troberson/artemis-project/CWC_Report/titlepage/titlepage.tex

\documentclass[../ewet_cwc_report.tex]{subfiles}

\NewDocumentCommand{\name}{m}{\underline{\textbf{#1}}}

\begin{document}

\makeatletter
\begin{titlepage}
  \begin{minipage}[T]{0.45\textwidth}
    \begin{flushleft}
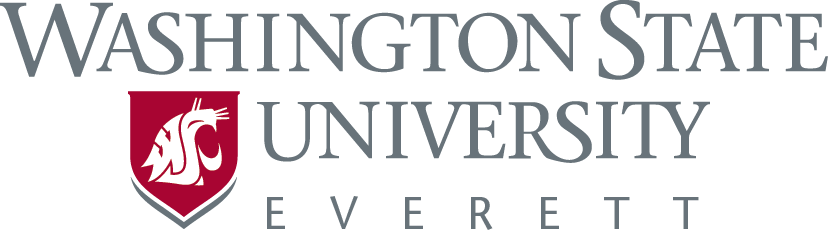
[picture p39: CWC_Report/_images/wsu.png]
      
    \end{flushleft}
  \end{minipage}
  \begin{minipage}[T]{0.45\textwidth}
    \begin{flushright}
      
    \end{flushright}
  \end{minipage}

  \centering
  \vspace*{5cm}

  {\large
    Washington State University-Everett and\\
    Everett Community College \\
    Collegiate Wind Competition \\
    Final Report\\
    April 24, 2022
  }

  \vspace*{20ex}

  \textbf{Team Members}
  \vspace*{1ex}

  \begin{tabular}{cccc}
    \name{Steven Fordham} &
    \name{James Garfield} &
    \name{Boris Gindlin}    \\
    WSU                   &
    EvCC                  &
    WSU                     \\
    Electrical Team Lead  &
    MakerPlot Research    &
    Electrical Design       \\
    Turbine Controls      &
                          &
    Generator Design        \\
    Electrical Design     &
                          &
    Load Design
  \end{tabular}

  \vspace*{2ex}

  \begin{tabular}{cc}
    \name{Dan}           &
    \name{Tamara Roberson} \\
    WSU                  &
    WSU                    \\
    Mechanical Team Lead &
    Load Controls          \\
    Aerodynamics           \\
    Foundation Design      \\
    Rotor and Pitch Control Design
  \end{tabular}

  \vspace*{4ex}

  \textbf{Faculty Advisors}
  \vspace*{1ex}

  \begin{tabular}{ccc}
    \name{Gordon Taub}     &
    \name{Joe Graber}      &
    \name{Xie Shuzheng}      \\
    WSU                    &
    EvCC                   &
    WSU                      \\
    Principle Investigator &
    Co-PI                  &
    Co-PI
  \end{tabular}

\end{titlepage}
\makeatother

\end{document}
