troberson/artemis-project/Presentation/Offshore Wind Turbine Prototype.pptx

## Offshore Wind Turbine Prototype

Tamara Roberson
Candidate for Associate Software Engineer

## Who Am I?

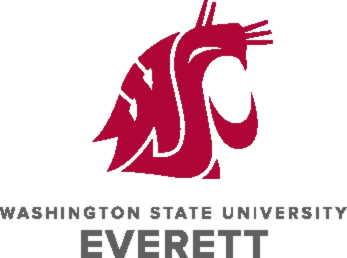
[picture p40: figure]

- Tamara Roberson
- Graduating from WSU Everett with a BSEE this week
- Starting a career in embedded software
- Hobby: Board Games

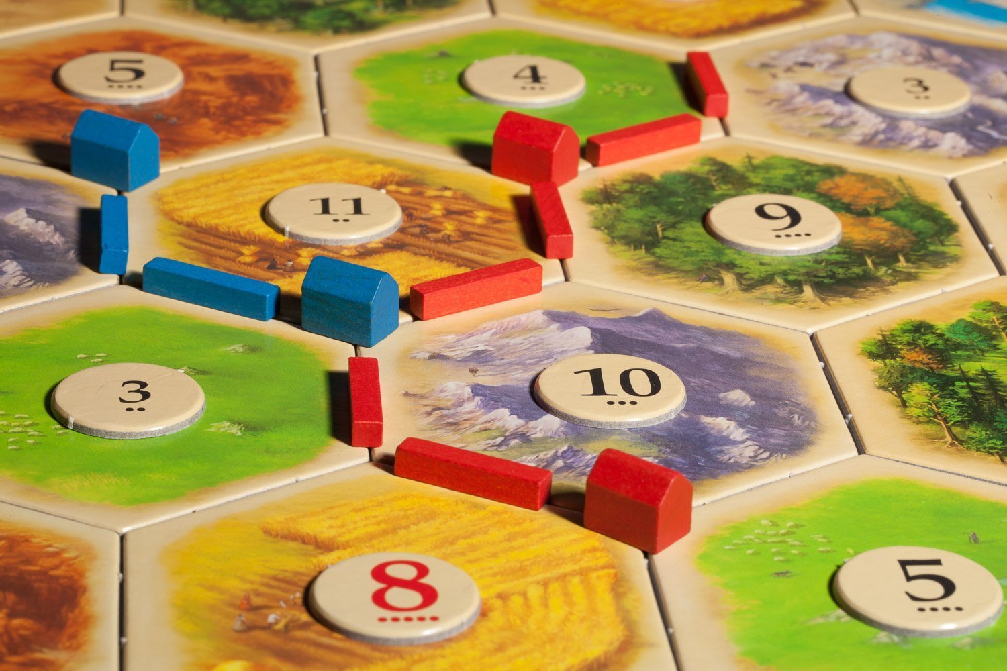
[picture p41: figure]

## Who Are You?

- Name
- Specialization
  - Not your job title
  - What are you the “go to” person for?
  - React? Analog ICs? LaTeX?
- Hobby
  - Open-Source Software? Video Games? Hiking? Museums?

## The Team

- Senior Design Project and Engineering Club Team
- US Department of Energy Collegiate Wind Competition
- Team of 3 EEs, 1 ME
  - Club also includes several Business and Communications students for outreach and wind farm business analysis

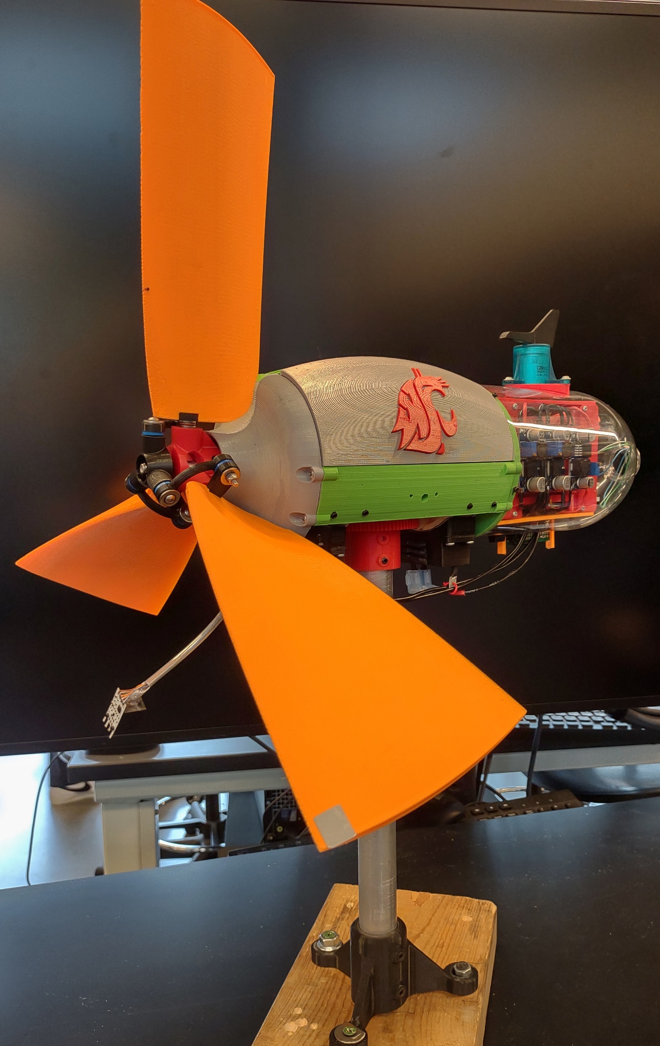
[picture p42: figure]

## Design Considerations

- Collegiate Wind Competition rules
- Offshore wind turbine designed to be installed in the Gulf of Mexico
