troberson/artemis-project/Midterm_Report/ext/tasks.pdf

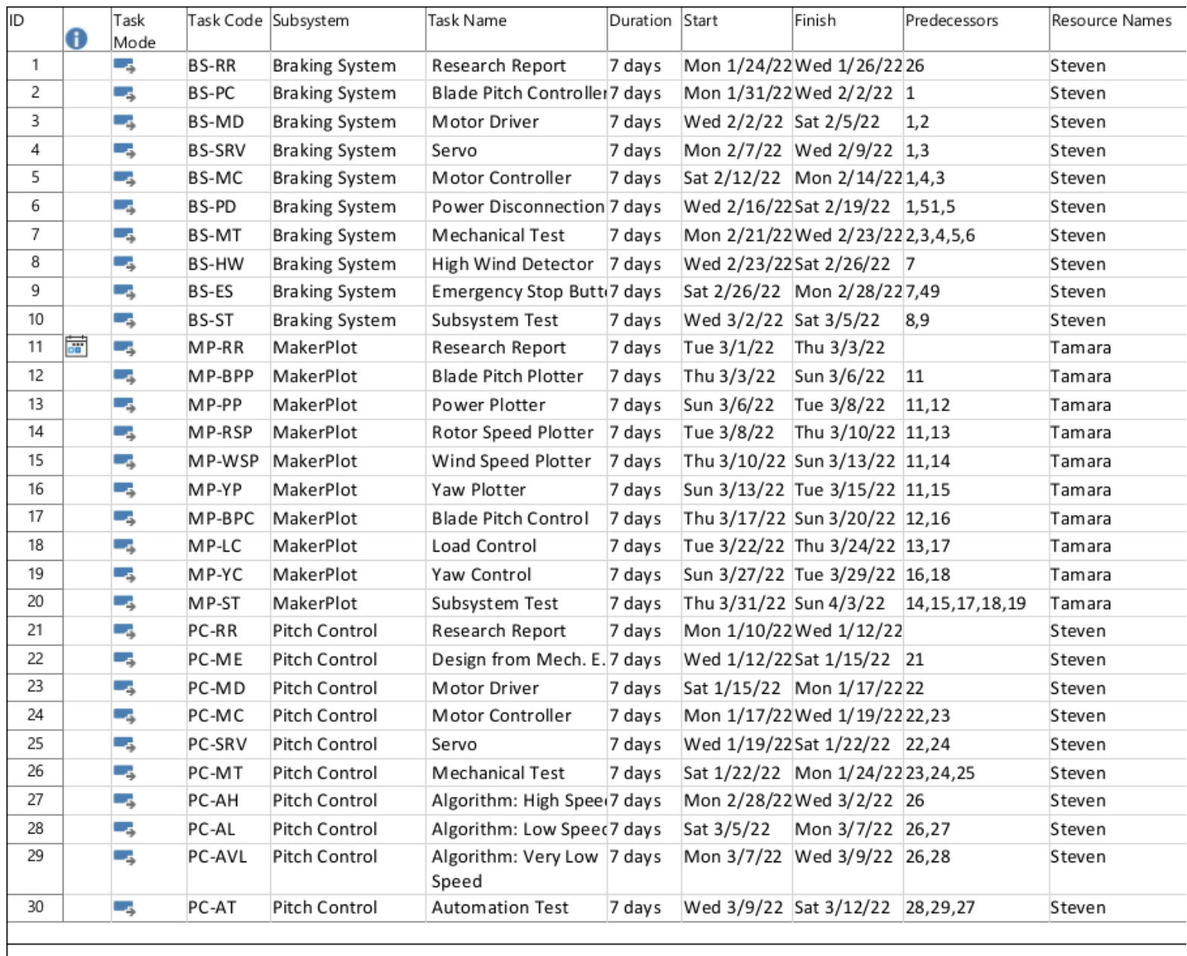
[picture p43: page 1]
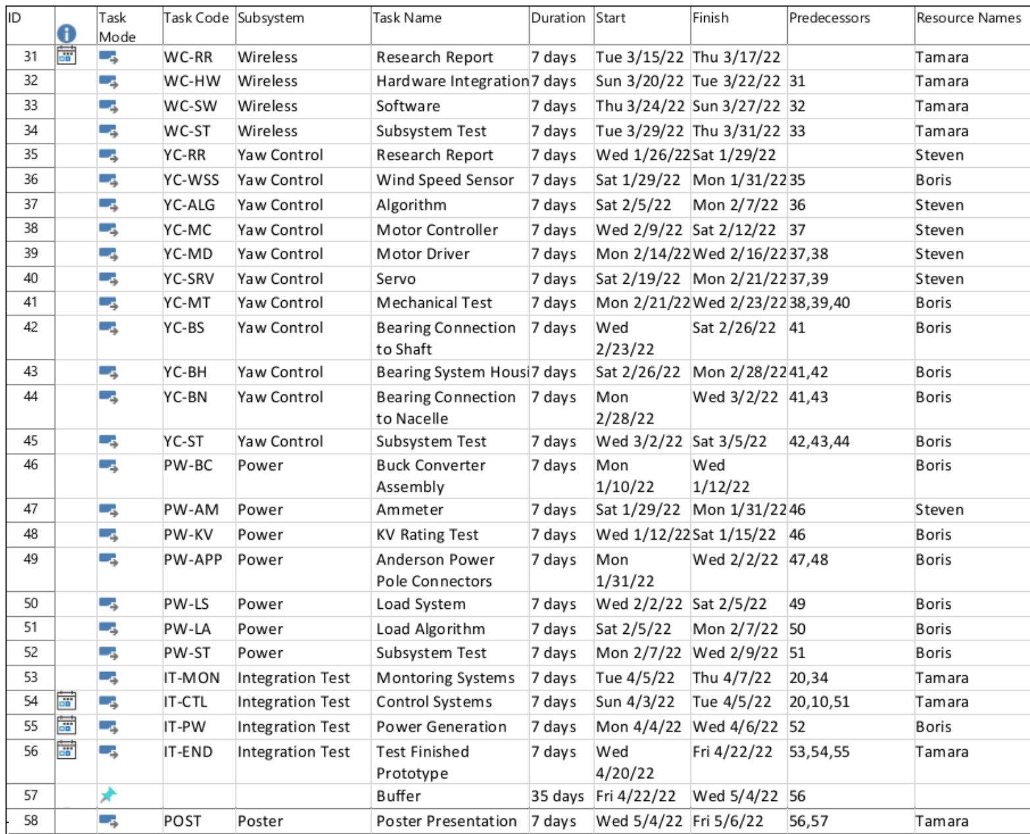
[picture p44: page 2]
