troberson/artemis-project/Midterm_Report/images/load_control.png

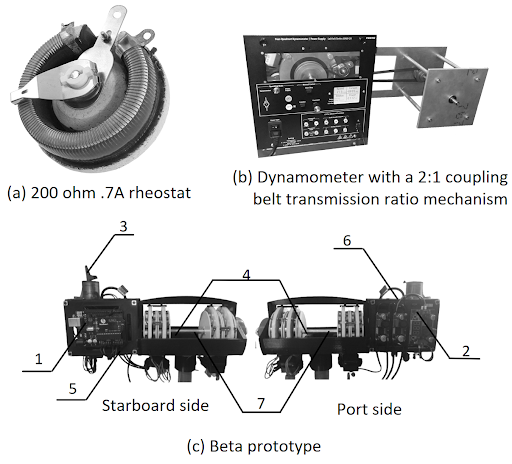
Midterm_Report/images/load_control.png
