troberson/artemis-project/Presentation/afpmg2.png

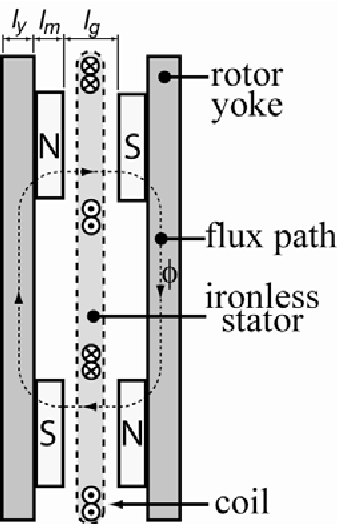
Presentation/afpmg2.png
