troberson/artemis-project/Presentation/afpmg.png

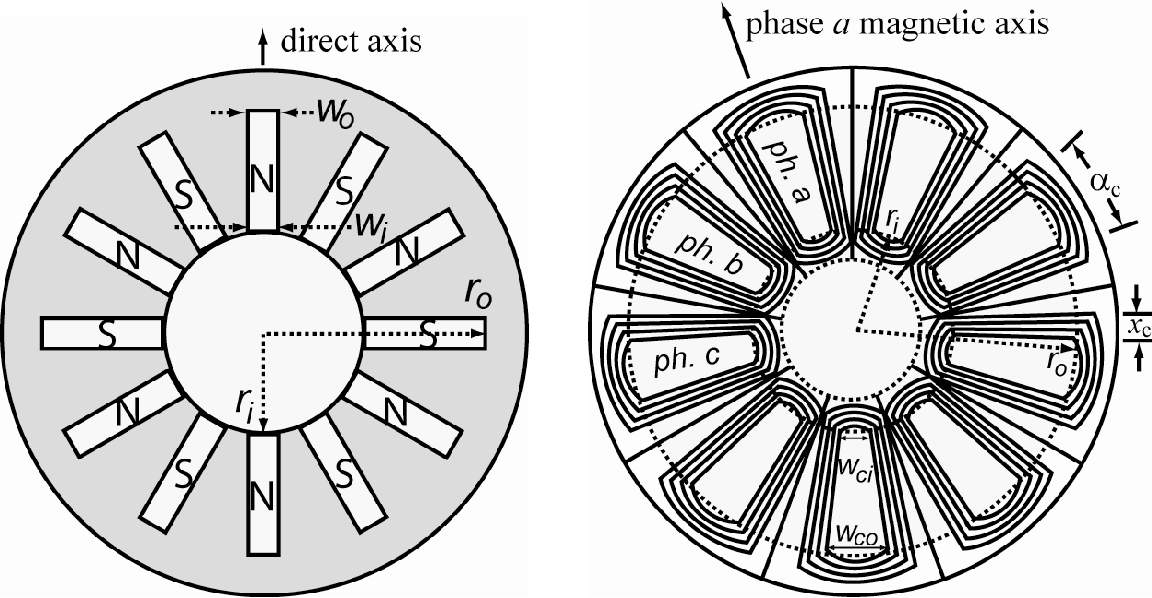
Presentation/afpmg.png
