troberson/artemis-project/Presentation/arduino_load.jpg

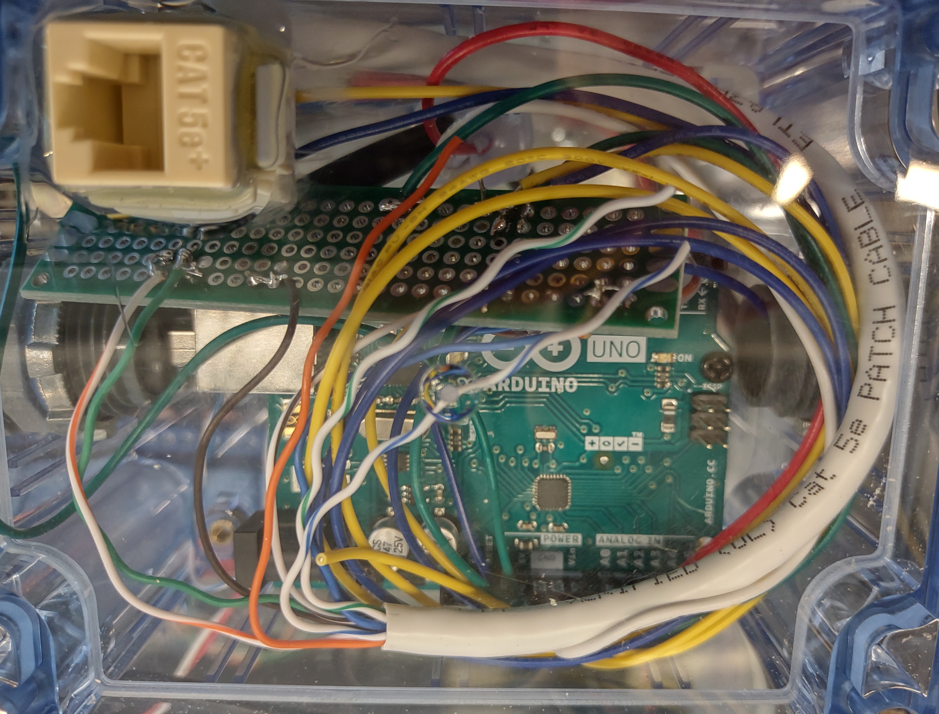
Presentation/arduino_load.jpg
