troberson/artemis-project/Presentation/arduino_turbine.jpg

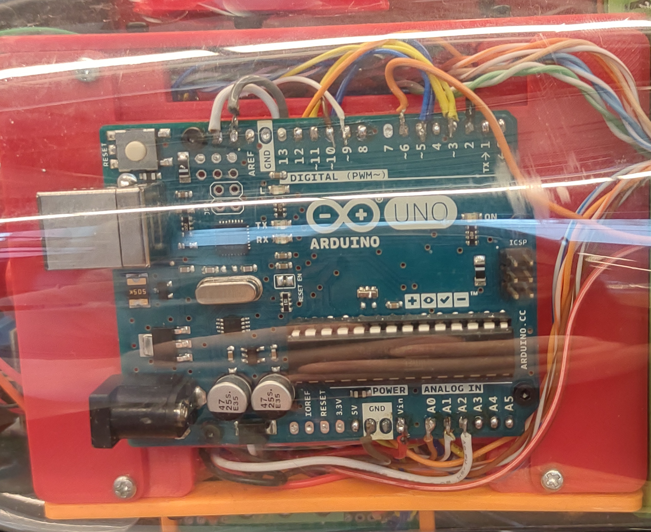
Presentation/arduino_turbine.jpg
