troberson/artemis-project/Presentation/buck.jpg

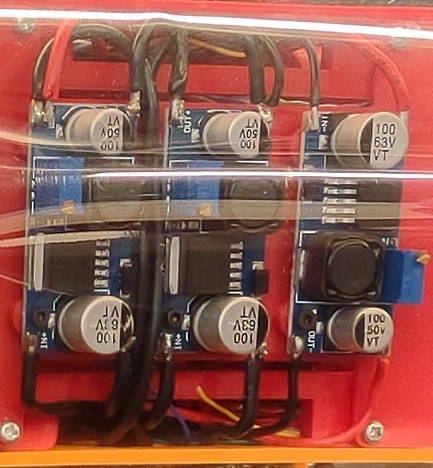
Presentation/buck.jpg
