troberson/artemis-project/Presentation/cwc.png

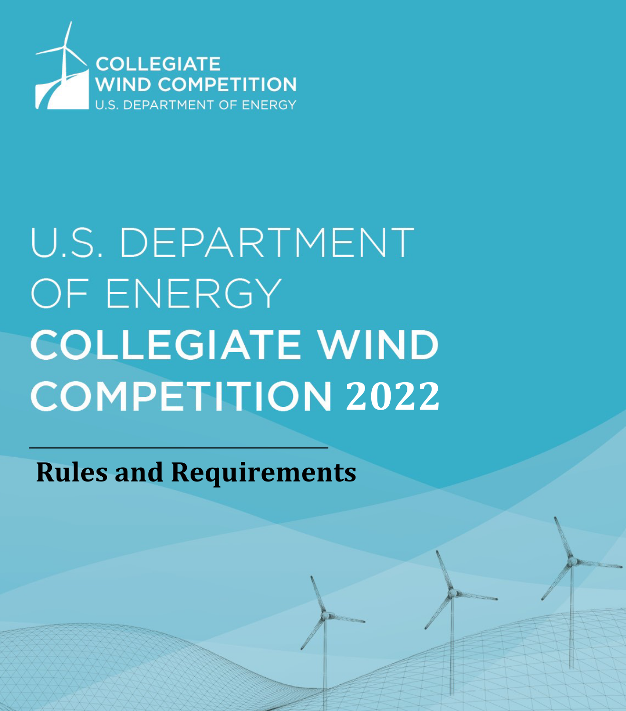
Presentation/cwc.png
