troberson/artemis-project/Presentation/generators.jpg

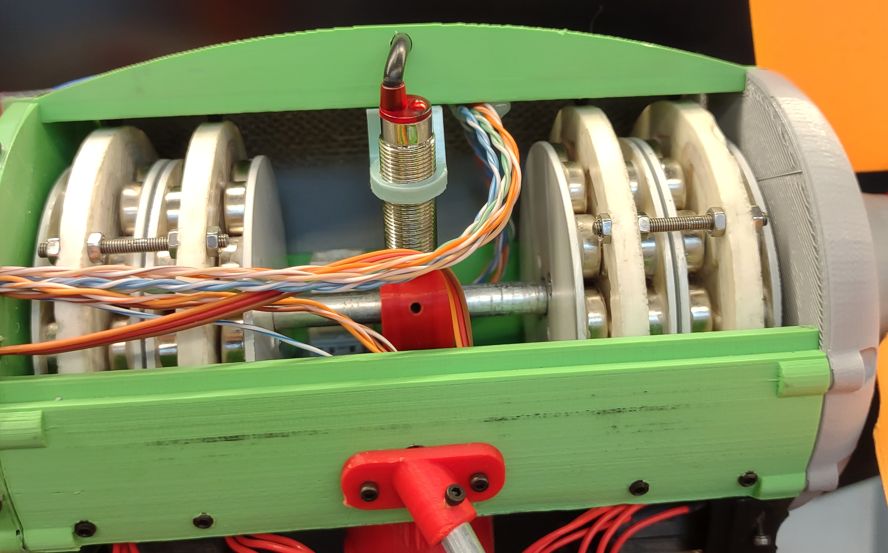
Presentation/generators.jpg
