troberson/artemis-project/Presentation/group.jpg

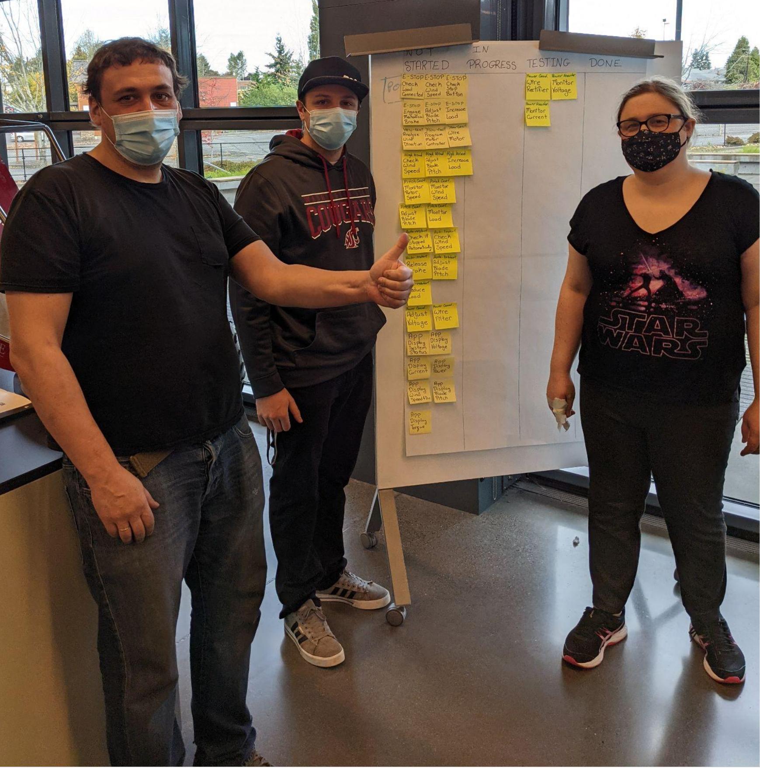
Presentation/group.jpg
