troberson/artemis-project/Presentation/load_box.jpg

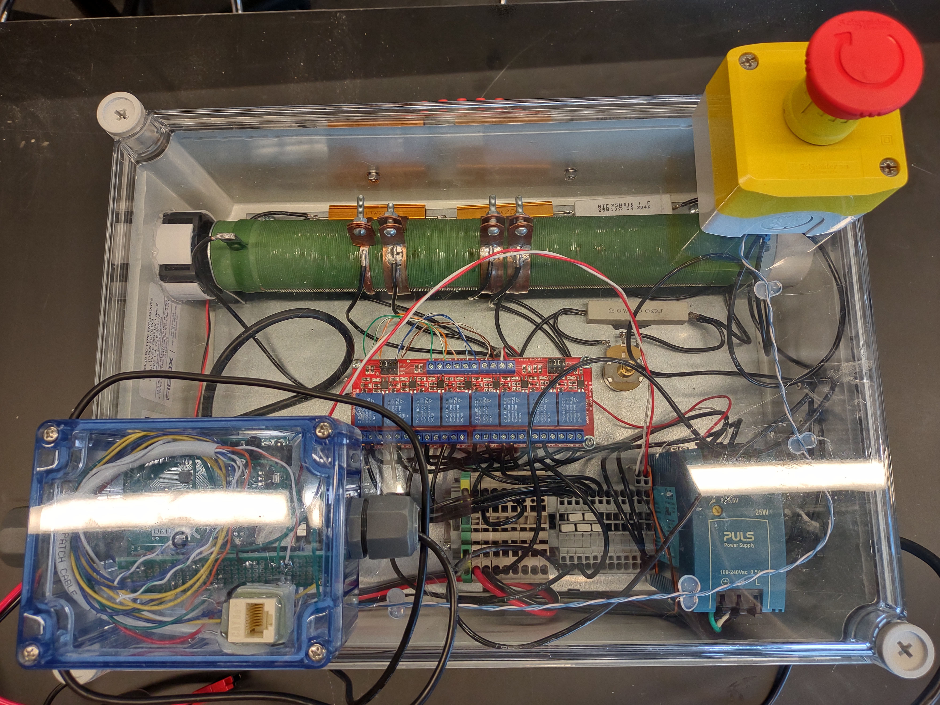
Presentation/load_box.jpg
