troberson/artemis-project/Presentation/pitch_control.png

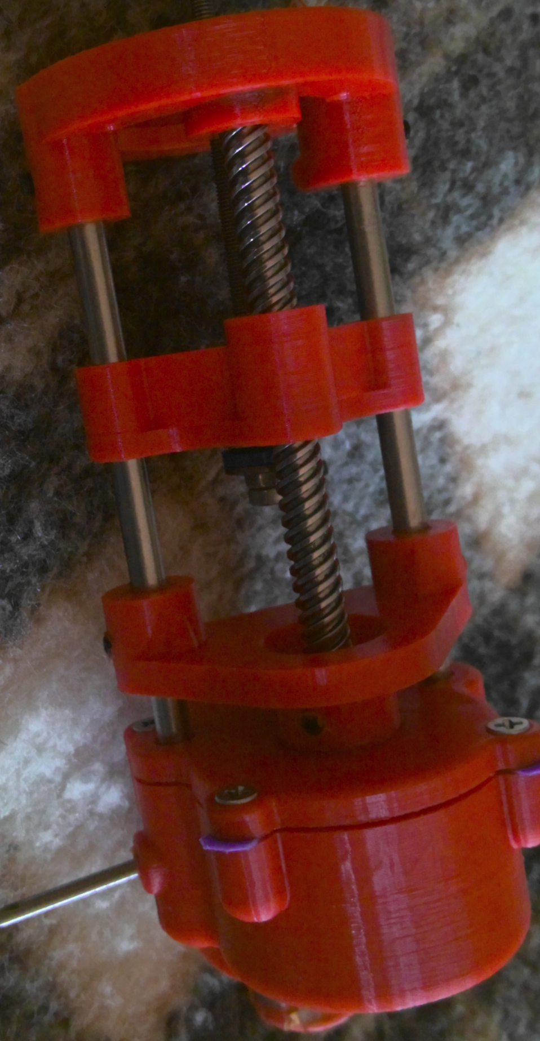
Presentation/pitch_control.png
