troberson/artemis-project/Presentation/precedence_closeup.png

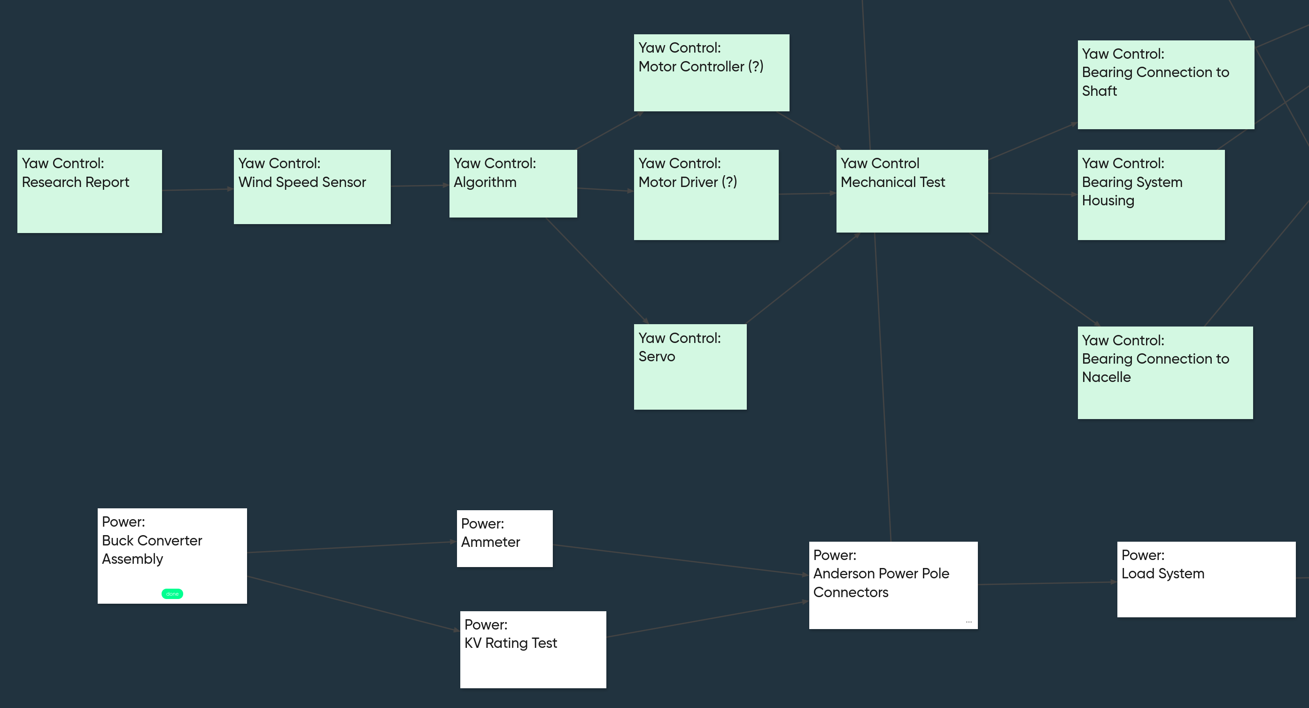
Presentation/precedence_closeup.png
