troberson/artemis-project/Presentation/precedence_overview.png

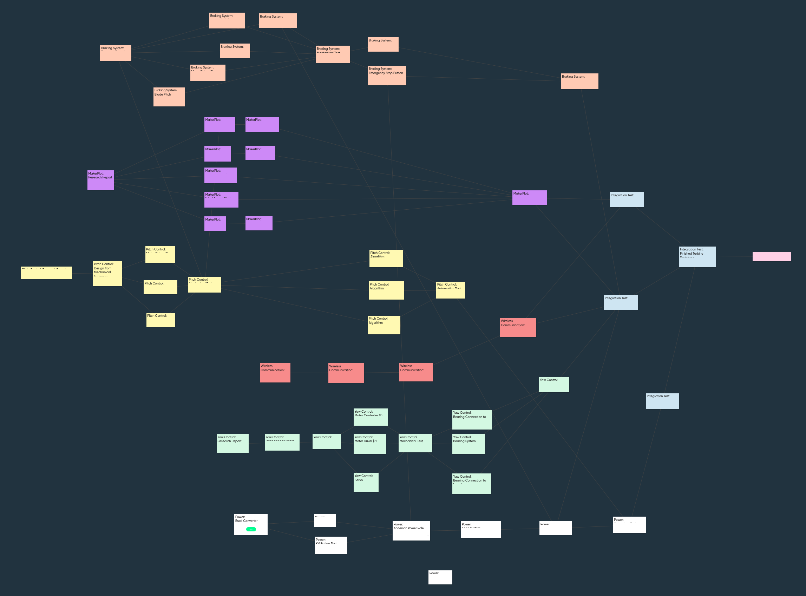
Presentation/precedence_overview.png
