troberson/artemis-project/Presentation/schematic.png

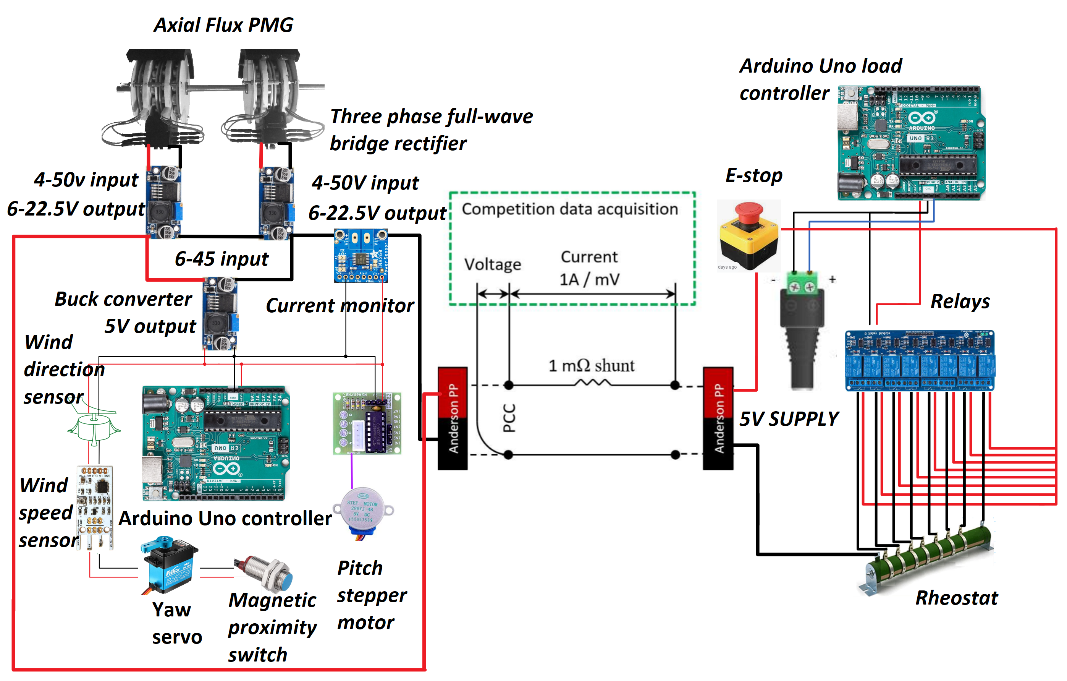
Presentation/schematic.png
