troberson/artemis-project/Presentation/software_load.png

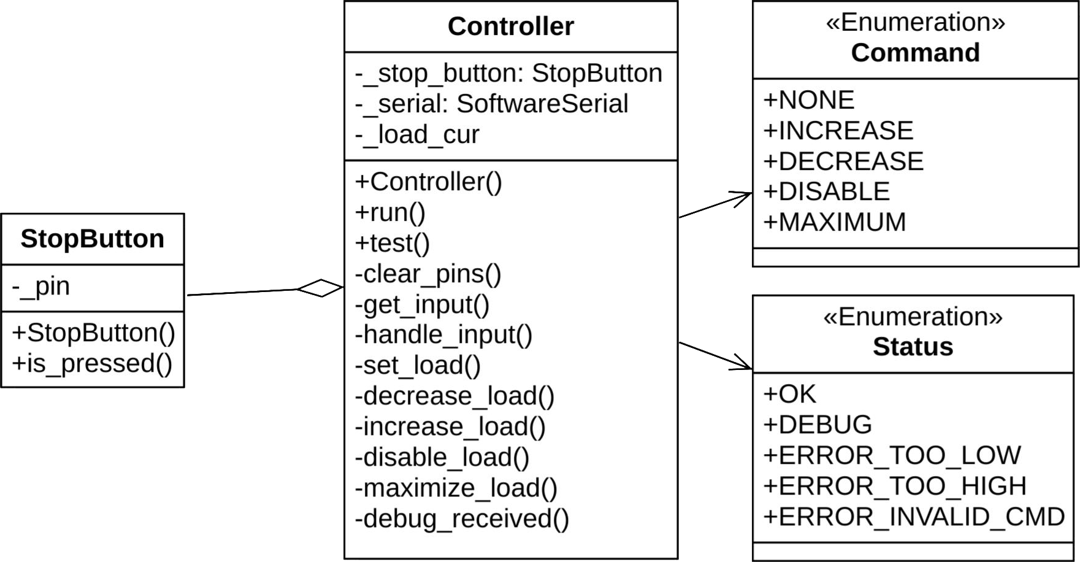
Presentation/software_load.png
