troberson/artemis-project/Presentation/software_turbine.png

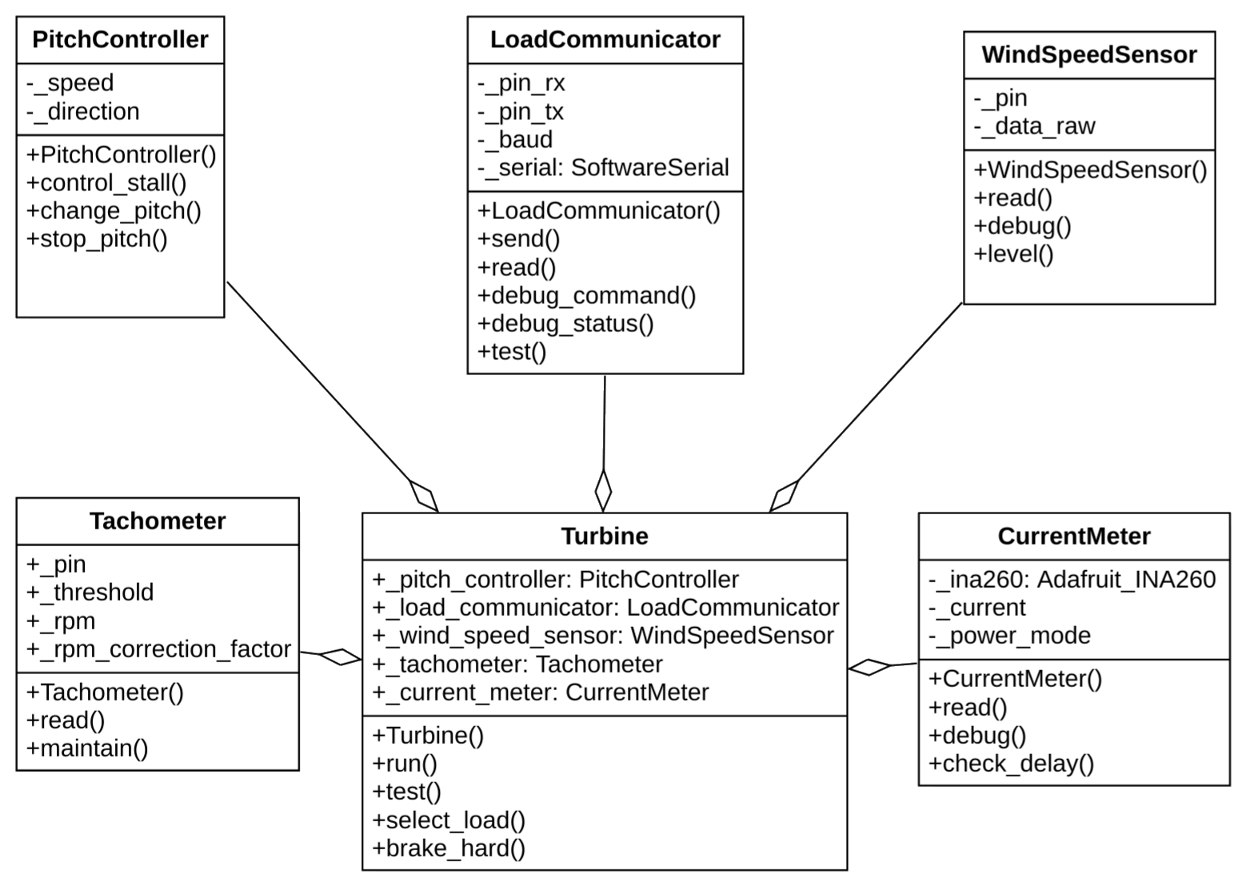
Presentation/software_turbine.png
