troberson/artemis-project/Presentation/tasks.jpg

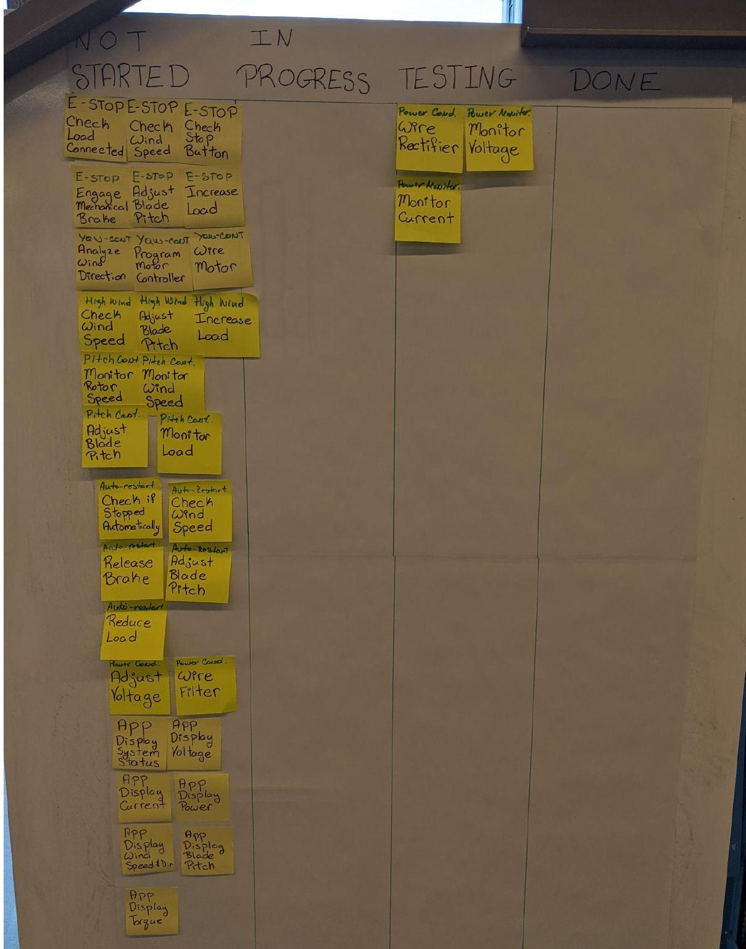
Presentation/tasks.jpg
