troberson/artemis-project/Presentation/turbine_closeup.jpg

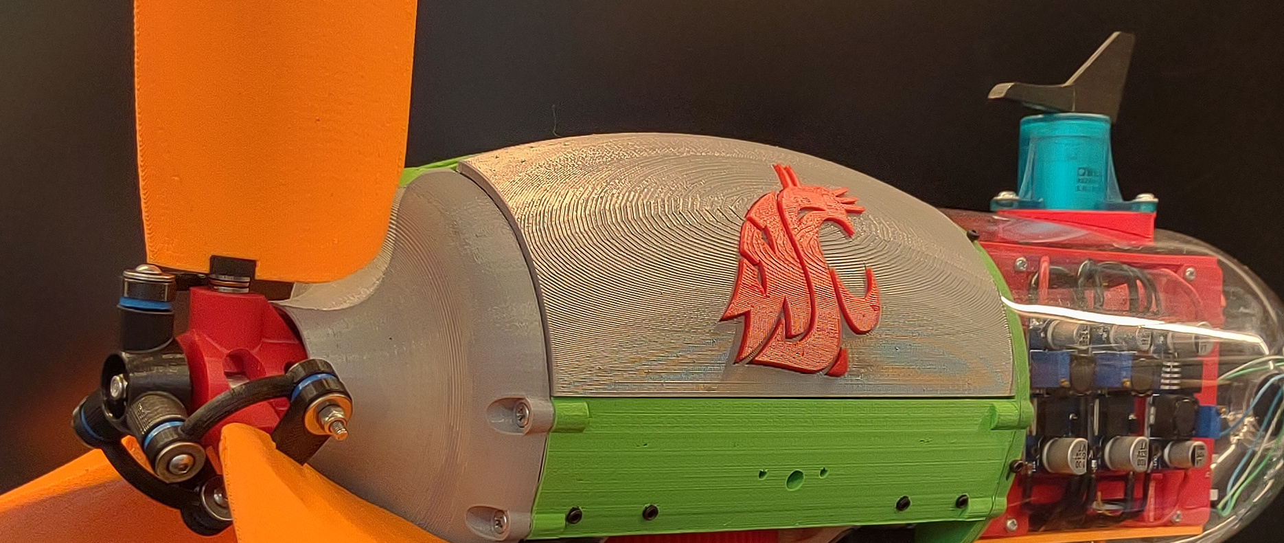
Presentation/turbine_closeup.jpg
