troberson/artemis-project/Presentation/wind_speed2.png

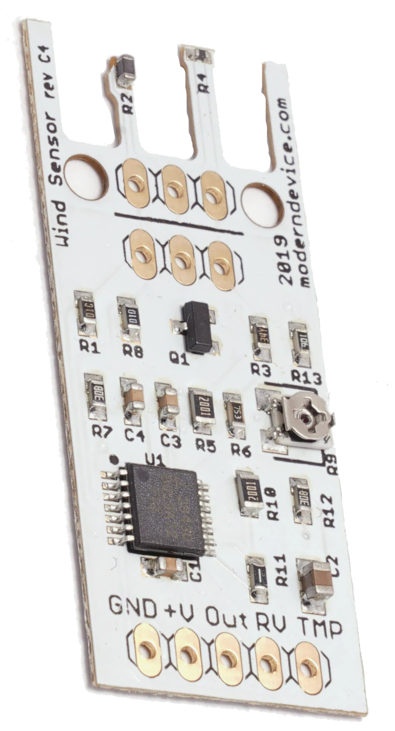
Presentation/wind_speed2.png
