troberson/artemis-project/Presentation/wind_speed2.webp

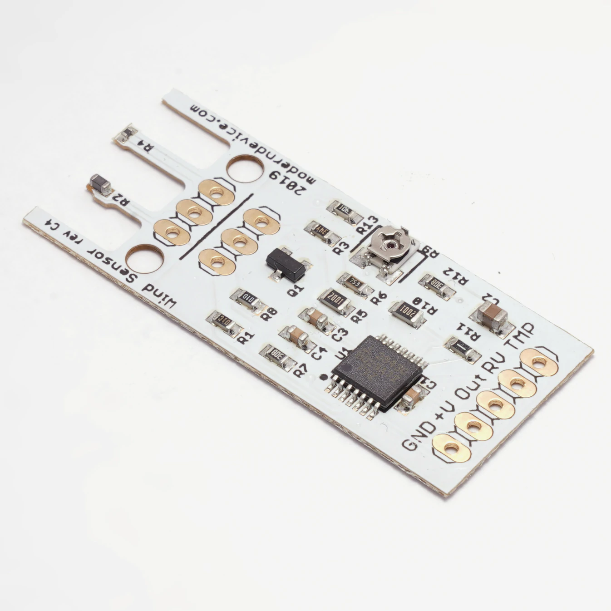
Presentation/wind_speed2.webp
