troberson/artemis-project/Presentation/wind_speed.png

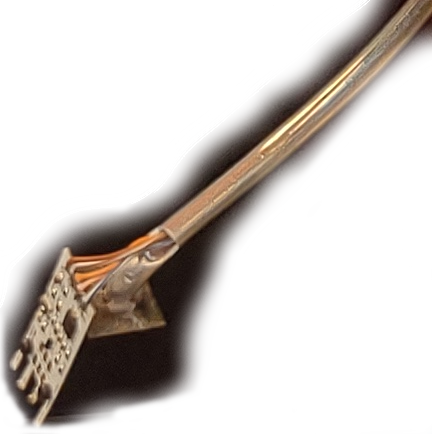
Presentation/wind_speed.png
