troberson/artemis-project/Presentation/yaw.jpg

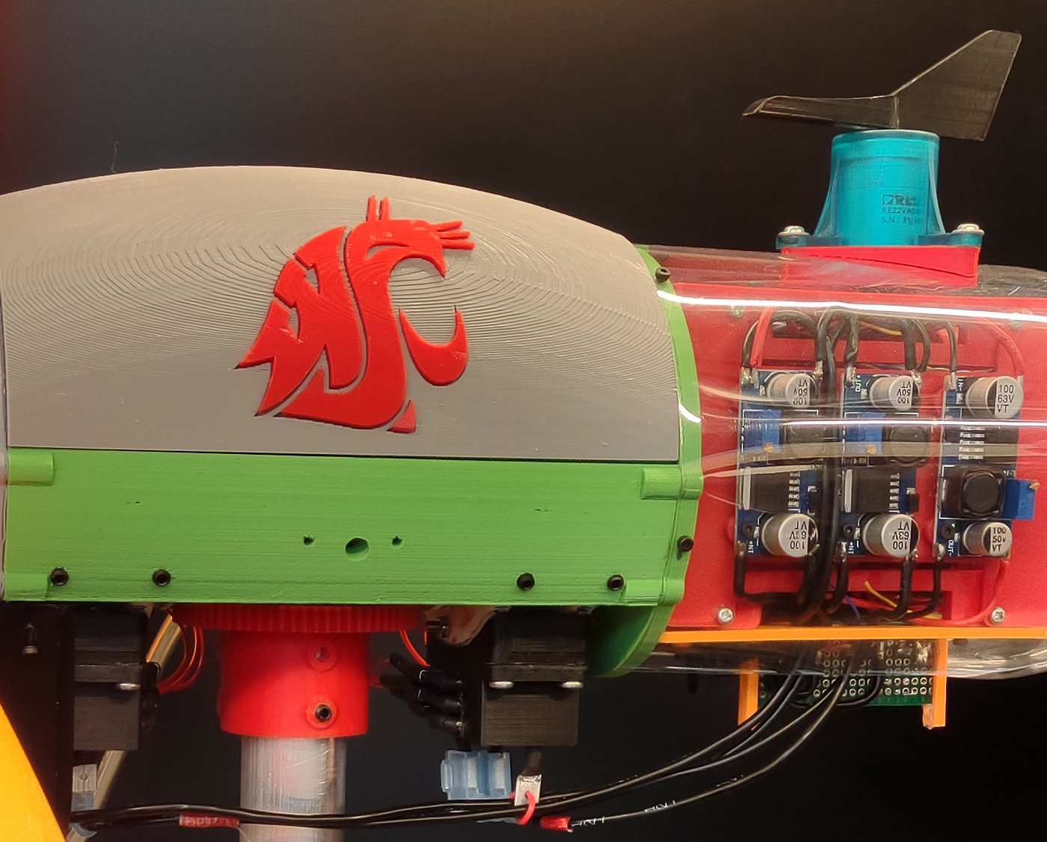
Presentation/yaw.jpg
