troberson/artemis-project/Presentation/testing2.jpg

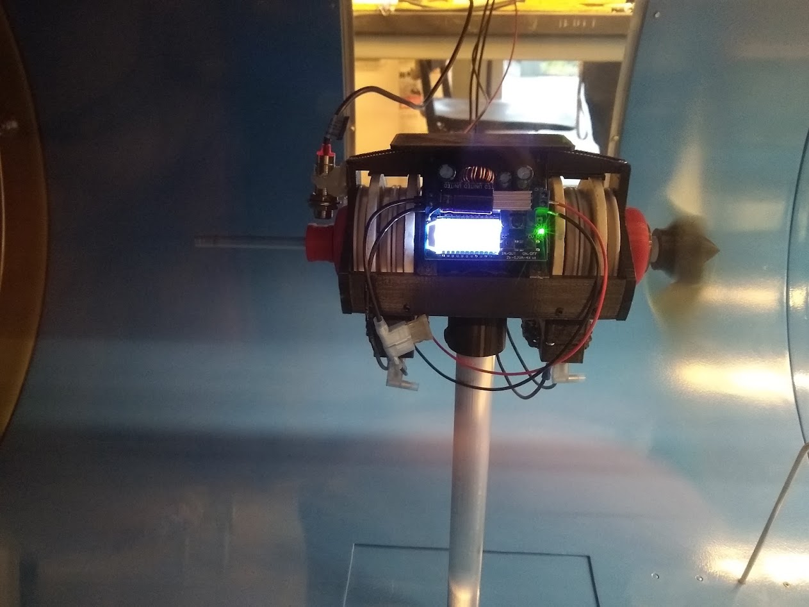
Presentation/testing2.jpg
