troberson/artemis-project/Presentation/testing3.jpg

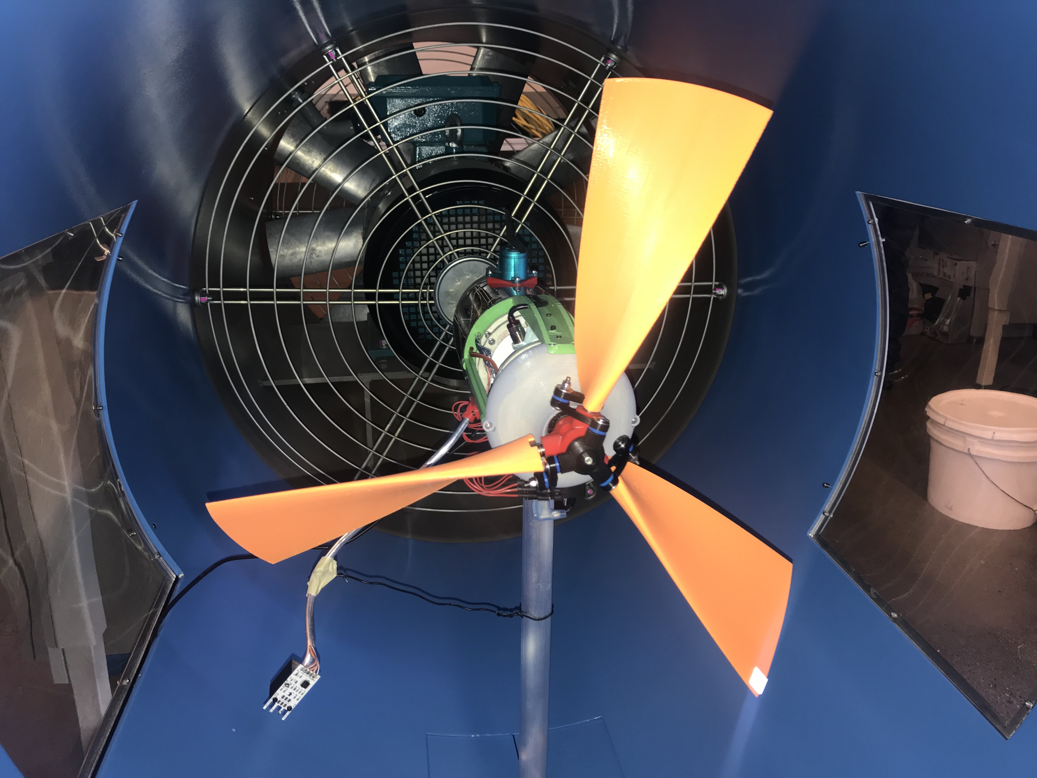
Presentation/testing3.jpg
