troberson/artemis-project/Presentation/testing.jpg

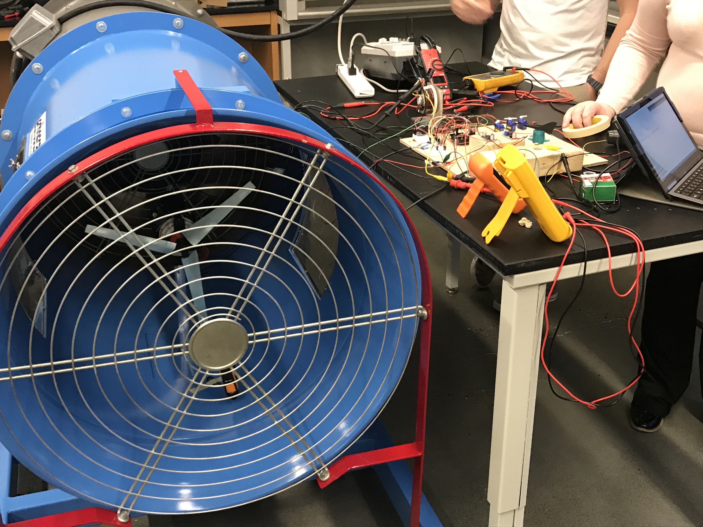
Presentation/testing.jpg
