troberson/artemis-project/Presentation/testing_tension.jpg

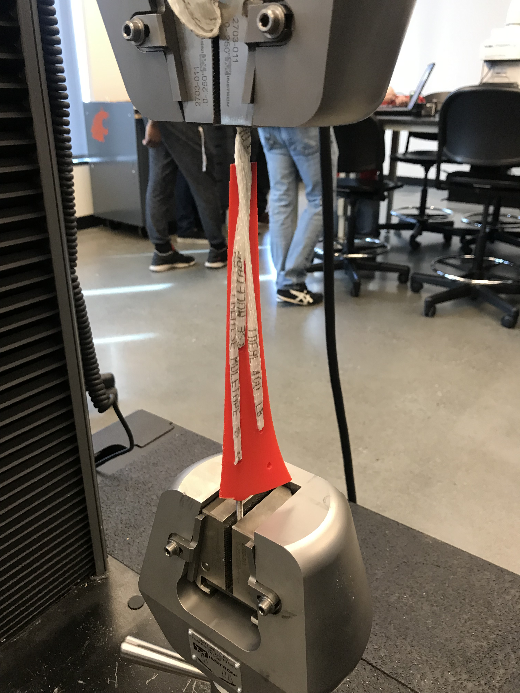
Presentation/testing_tension.jpg
