troberson/artemis-project/(commit log)

2022-04-13 Add Arduino code.
2022-04-13 Arduino: Reformat.
2022-04-13 Arduino: Initial cleanup (compiles, untested).
2022-04-13 Arduino: Add load comms.
2022-04-13 Arduino: Add LoadController.
2022-04-13 Arduino: Remove wind speed sensor GND and VCC.
2022-05-09 Add Arduino communication.
2022-05-09 Add PowerPoint presentation.
